Kelschsd/Smart-Pill-Organizer/Media/KeypadWiring.png

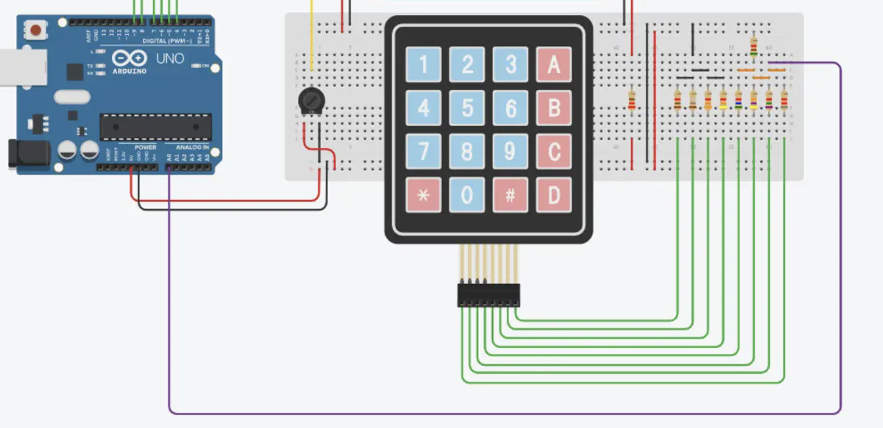
Media/KeypadWiring.png
