Kelschsd/Smart-Pill-Organizer/Media/keypad.jpg

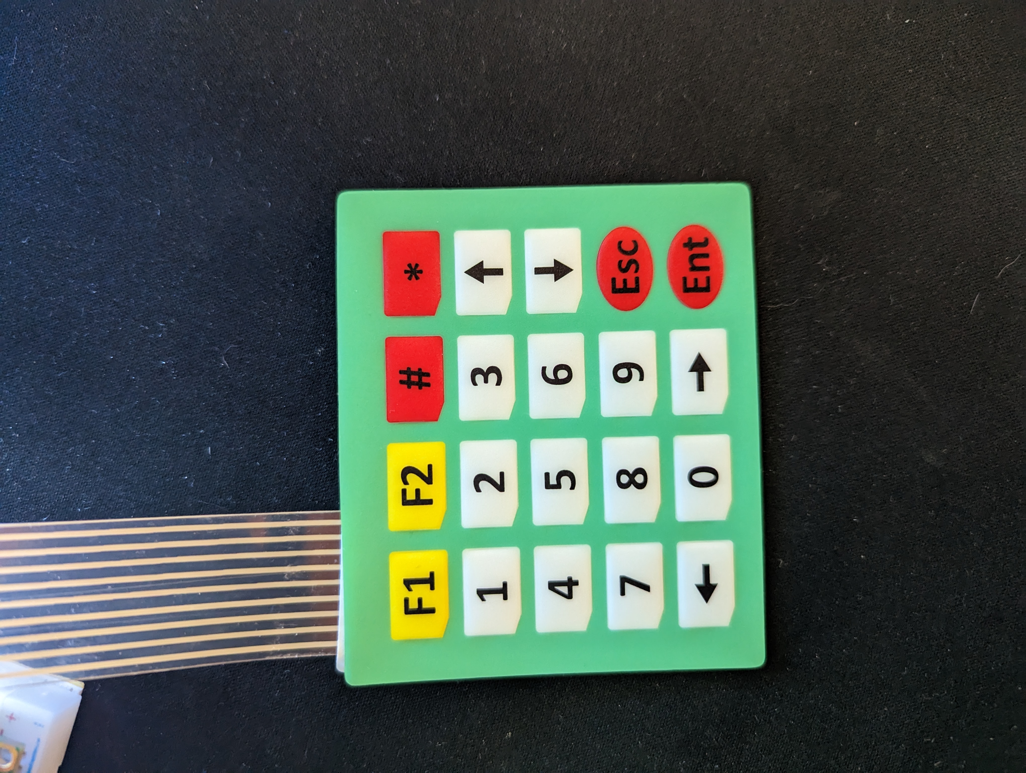
Media/keypad.jpg
