Kelschsd/Smart-Pill-Organizer/README

Read the Github Wiki page for more information.
