Kelschsd/Smart-Pill-Organizer/Media/day-select-screen.jpg

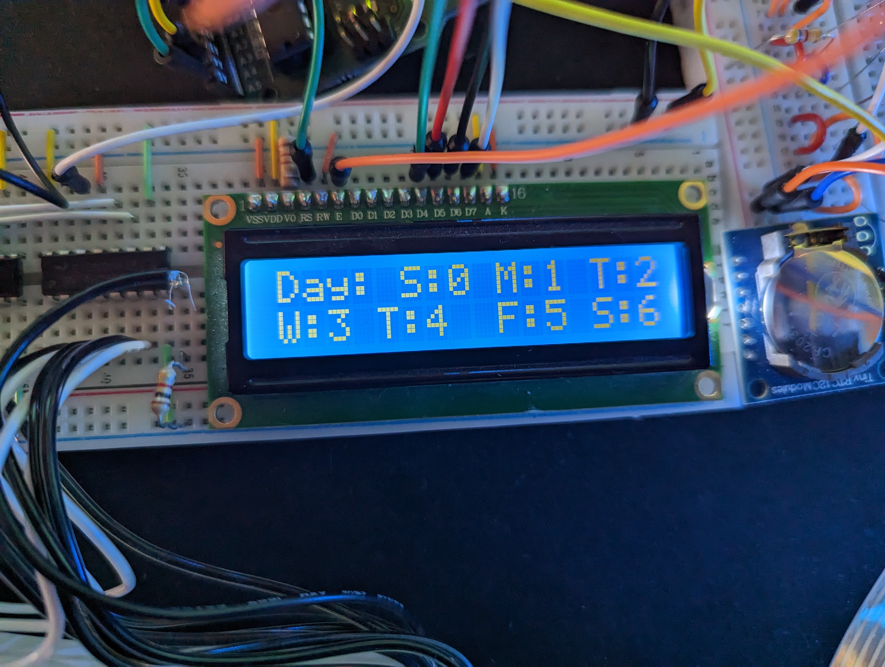
Media/day-select-screen.jpg
