Kelschsd/Smart-Pill-Organizer/Media/pill-organizer.jpg

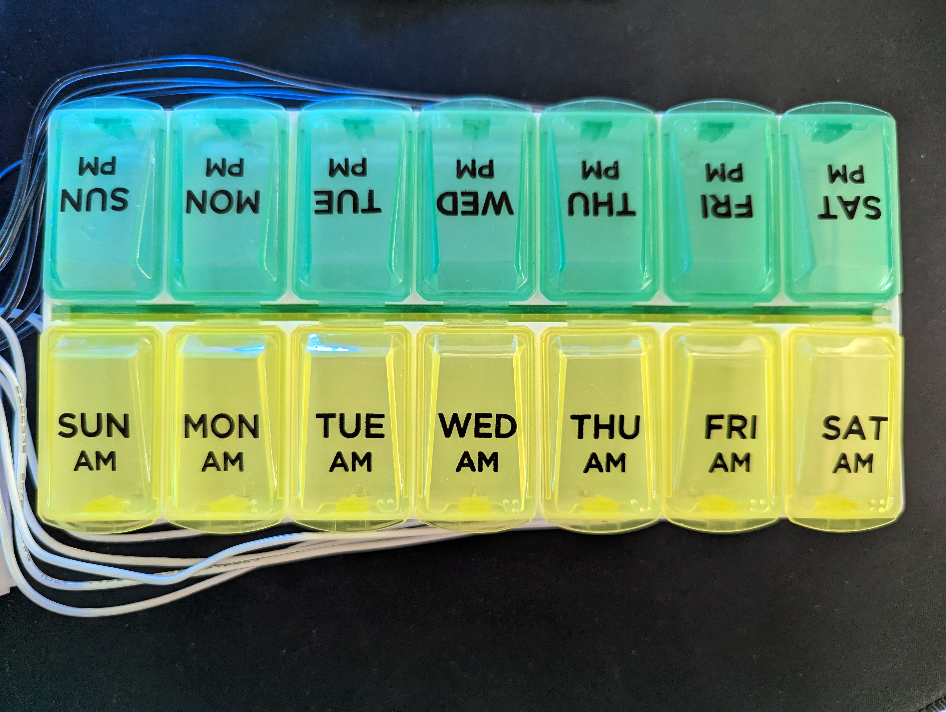
Media/pill-organizer.jpg
