Kelschsd/Smart-Pill-Organizer/Media/PinDiagram.PNG

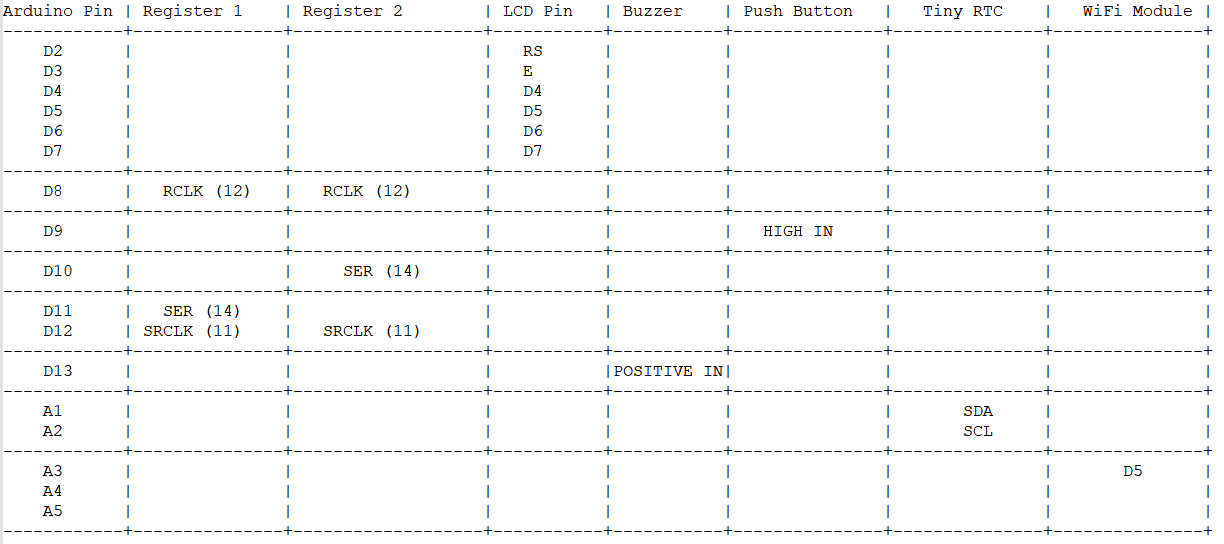
Media/PinDiagram.PNG
