Kelschsd/Smart-Pill-Organizer/Media/sms-code.png

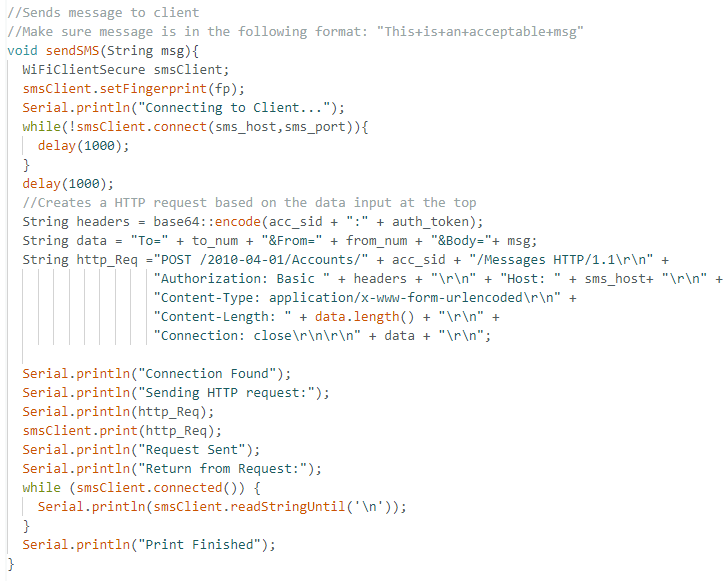
Media/sms-code.png
