Kelschsd/Smart-Pill-Organizer/Media/time-screen.jpg

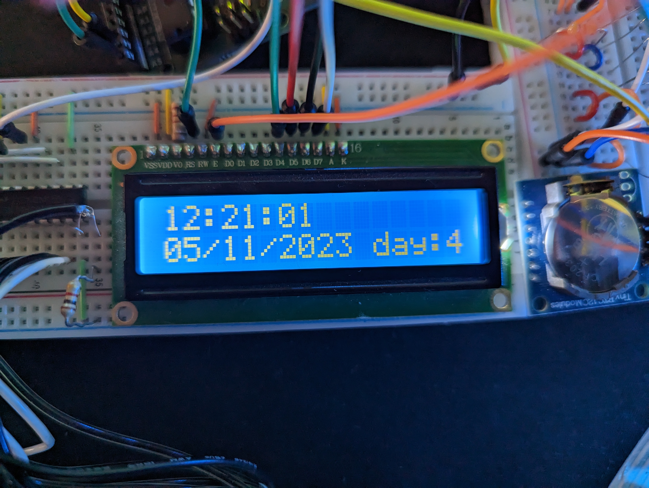
Media/time-screen.jpg
