Kelschsd/Smart-Pill-Organizer/Media/twillo-log-in.png

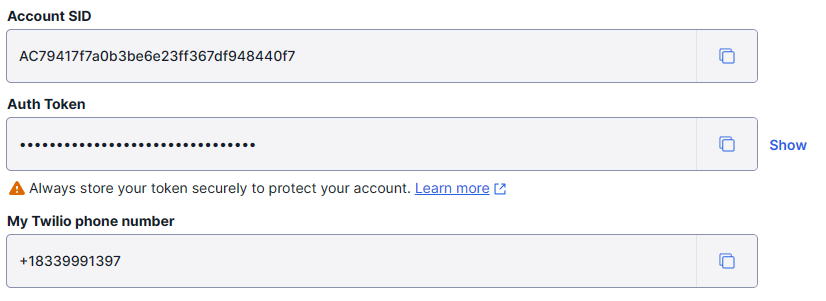
Media/twillo-log-in.png
