Kelschsd/Smart-Pill-Organizer/(commit log)

2023-04-19 Add files via upload
    Current program for sending an SMS
2023-05-10 Add files via upload
    lib files in "src" folder to work with newer versions of Arduino IDE
