Kelschsd/Smart-Pill-Organizer/Media/notification-light.jpg

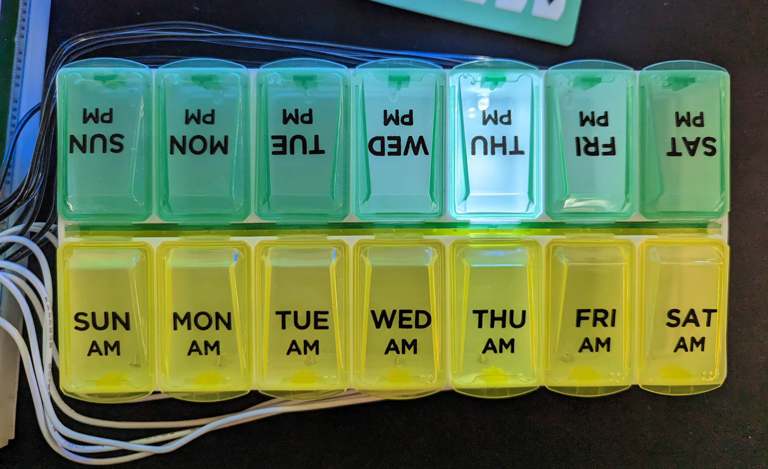
Media/notification-light.jpg
